desmond-02/2dof_camera_control/ros2/src/camera_mount_description/urdf/assets/d455.stl

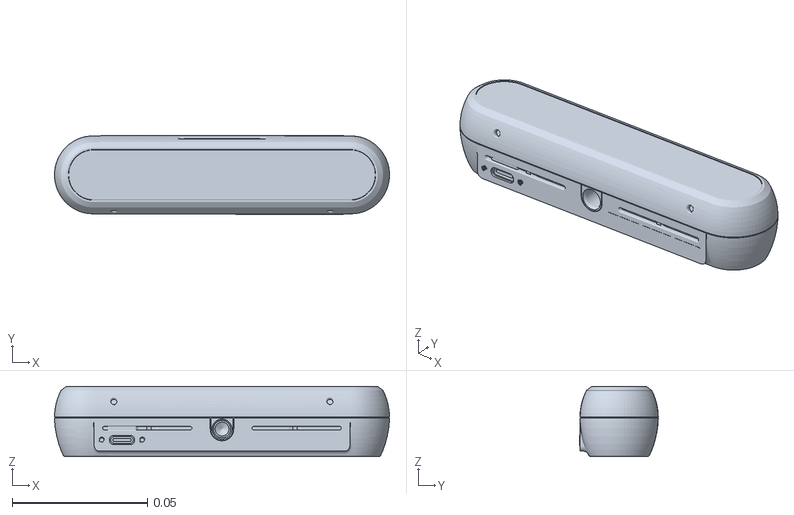
[picture p3: CAD file, 2026-09-07]
ros2/src/camera_mount_description/urdf/assets/d455.stl
0.124 x 0.0291 x 0.026
