desmond-02/2dof_camera_control/ros2/src/camera_mount_description/urdf/assets/camera_mount_pitch_link.stl

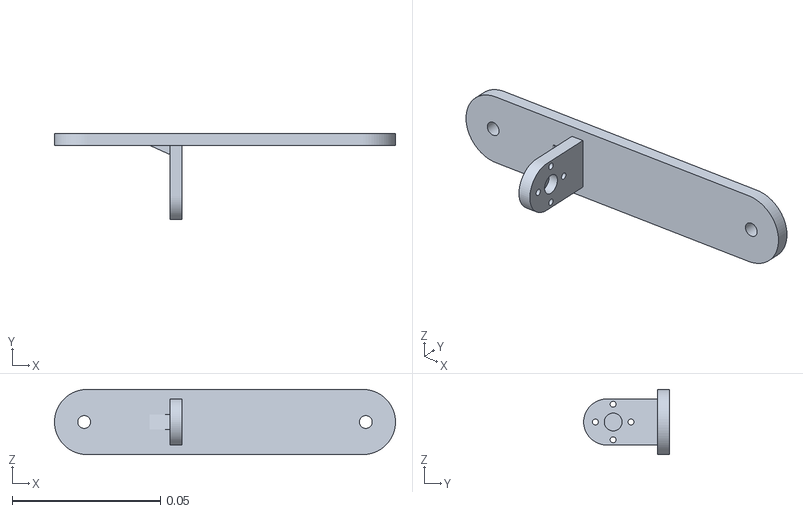
[picture p4: CAD file, 2026-09-07]
ros2/src/camera_mount_description/urdf/assets/camera_mount_pitch_link.stl
0.115 x 0.029 x 0.022
