desmond-02/2dof_camera_control/ros2/src/camera_mount_description/urdf/assets/camera_mount_base_link.stl

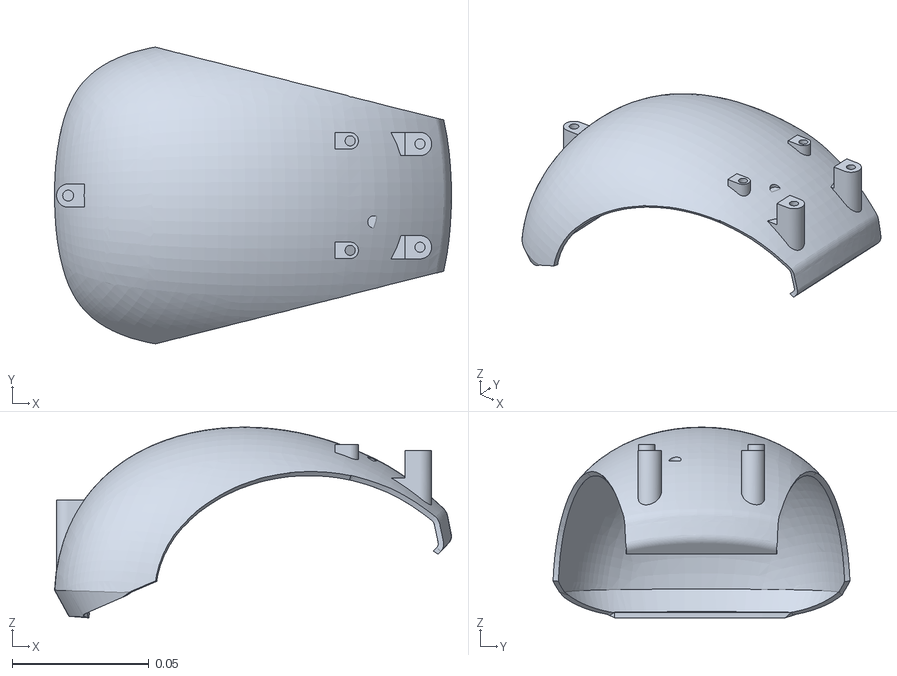
[picture p5: CAD file, 2026-09-07]
ros2/src/camera_mount_description/urdf/assets/camera_mount_base_link.stl
0.145 x 0.108 x 0.0697
