desmond-02/2dof_camera_control/ros2/src/camera_mount_description/urdf/assets/dc15_a01_case_f_dummy.stl

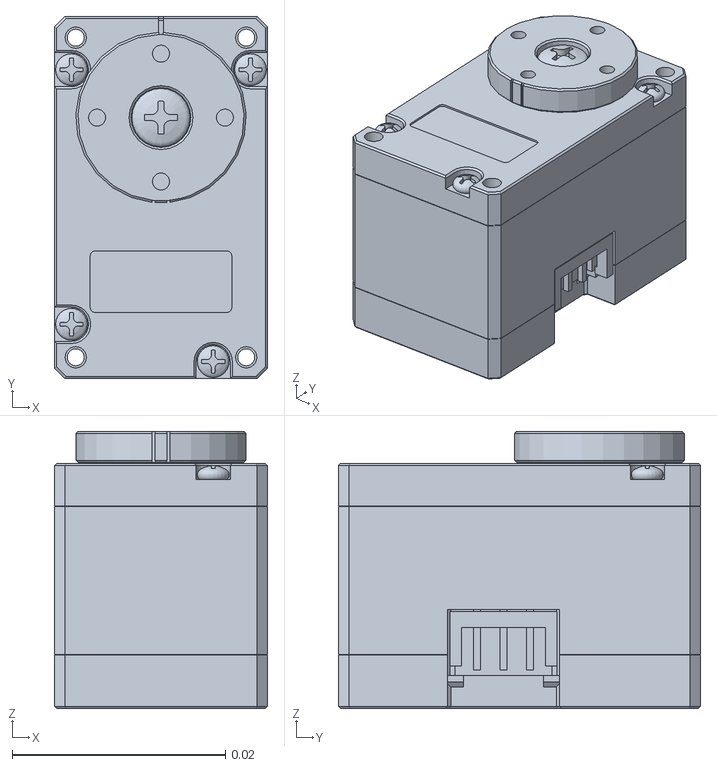
[picture p6: CAD file, 2026-09-07]
ros2/src/camera_mount_description/urdf/assets/dc15_a01_case_f_dummy.stl
0.02 x 0.034 x 0.026
