desmond-02/2dof_camera_control/ros2/src/camera_mount_description/urdf/assets/base_mount.stl

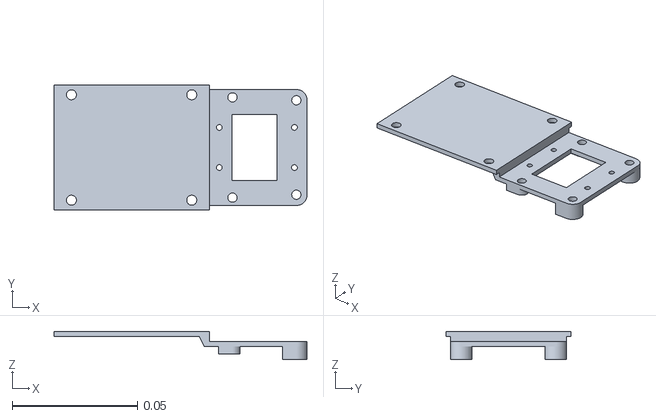
[picture p7: CAD file, 2026-09-07]
ros2/src/camera_mount_description/urdf/assets/base_mount.stl
0.101 x 0.05 x 0.0112
