desmond-02/2dof_camera_control/ros2/src/camera_mount_description/urdf/assets/camera_mount_yaw_link.stl

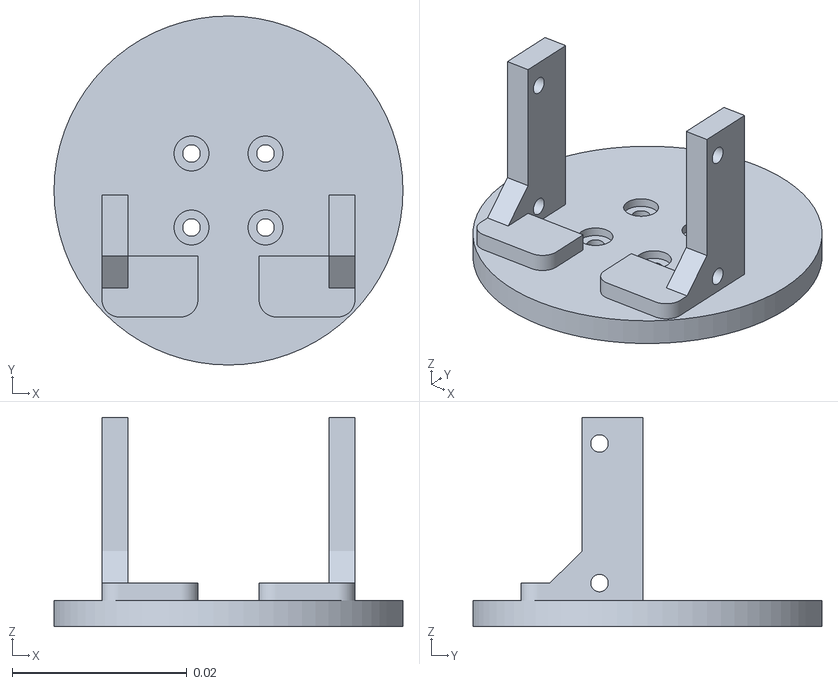
[picture p8: CAD file, 2026-09-07]
ros2/src/camera_mount_description/urdf/assets/camera_mount_yaw_link.stl
0.04 x 0.04 x 0.024
