desmond-02/2dof_camera_control/(commit log)

2026-09-05 add servo setup
    [servos.json]
2026-09-06 change some param
    [servos.json]
2026-09-06 change the structure
    [servos.json]
2026-09-06 add camera_mount_bridge
    [servos.json]
2026-09-06 solve the torque disable issue
    [camera_mount.urdf.xacro]
2026-09-06 recalibrate yaw
    [servos.json]
2026-09-07 added onshape exported urdf
    [base_mount.stl, camera_mount.urdf.xacro, camera_mount_base_link.stl, camera_mount_pitch_link.stl, camera_mount_standalone.urdf.xacro, camera_mount_yaw_link.stl, d455.stl, dc15_a01_case_f_dummy.stl]
2026-09-07 update the urdf
    [camera_mount.urdf.xacro, onshape.urdf]
2026-10-06 Add neck_zmq_bridge and a configurable startup home pose
    Brings the repo up to what has been deployed on the G1 since September
    but never committed:
    - neck_zmq_bridge: republishes /joint_states as ZMQ topic "neck_state"
    (port 5562) for g1_dataset_recorder's NeckZmqReader, and listens for
    "neck_cmd" to forward onto /joint_command.
    - bridge_node home_yaw_deg/home_pitch_deg parameters (default 0 =
    center); an out-of-range home falls back to center.
    - bringup.launch.py starts neck_zmq_bridge (enable_neck_zmq_bridge:=false
    to skip) and passes the home pose through.
    [bridge_node.py, neck_zmq_bridge.py]
2026-10-06 Make the bring-up safe across the encoder wrap and reliable on every boot
    Pitch's down stop sits right on the encoder's 4095->0 wrap (~4089-4106).
    After a power cycle with the camera resting there it can read ~5 instead
    of ~4101, and in single-turn Position Mode homing could then only reach
    the calibrated range by driving a near-full turn into the hard stop.
    - bridge_node runs the servos in Extended Position Mode and, at startup,
    picks the whole-turn offset that puts each raw reading nearest its
    calibrated center; goals and joint_states go through that offset. A
    joint starting >15 deg outside its range is left limp (servos.json
    doesn't match the hardware).
    - Startup pings every serv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
    [bridge_node.py, dynamixel_io.py]
2026-10-06 Recalibrate the mount after the U2D2 replacement (2026-10-06)
    New centers/limits from calibrate.py on the G1. Pitch is reversed (negative
    = down, checked on the robot) and its down limit is 4080 (-68.6 deg), just
    inside the encoder wrap, so the -65 deg boot home is in range. Yaw positive
    turns the camera to the robot's left (checked on the robot).
    [servos.json]
2026-10-12 Fix bridge_node hanging instead of exiting on a servo fault
    _fail() shut the rclpy context down from inside the joint_states timer
    callback. rclpy's shutdown hook then calls executor.shutdown(), which waits
    for in-flight callbacks to finish -- including the one making the call -- so
    the process deadlocked. ros2 launch kept running, comp-cap.service never
    restarted, and the neck stayed dead until a manual restart (seen on the robot
    2026-10-12 after another process reopened the U2D2 port at 460800 baud).
    _fail() now only records the fault; main() spins a private executor until the
    fault is set and shuts down outside any callback. Verified on the robot: a
    forced bus fault now exits with code 1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
2026-10-12 Make the U2D2 port private to the bring-up user
    The udev rule now sets OWNER=unitree, MODE=0600 instead of 0666. Another
    process reopening the port at a different baud rate drops the servos off the
    bus; on the G1, BrainCo's brainco_hand_server probes every /dev/ttyUSB* for
    hands and did exactly that. With the node unitree-owned 0600 and
    CAP_DAC_OVERRIDE removed from brainco_hand.service, it can no longer open the
    neck port, and udev re-applies the ownership whenever the U2D2 re-enumerates.
